omidpoyan/hardware/README.md

# Simple Oscilloscope Hardware

Top

- [Schematic.PDF](./Outputs/Schematic.PDF)
- [PCB 3D.PDF](./Outputs/PDF3D.PDF)
- [BOM.PDF](./Outputs/BOM.PDF)
