omidpoyan/hardware/Outputs/Schematic.PDF

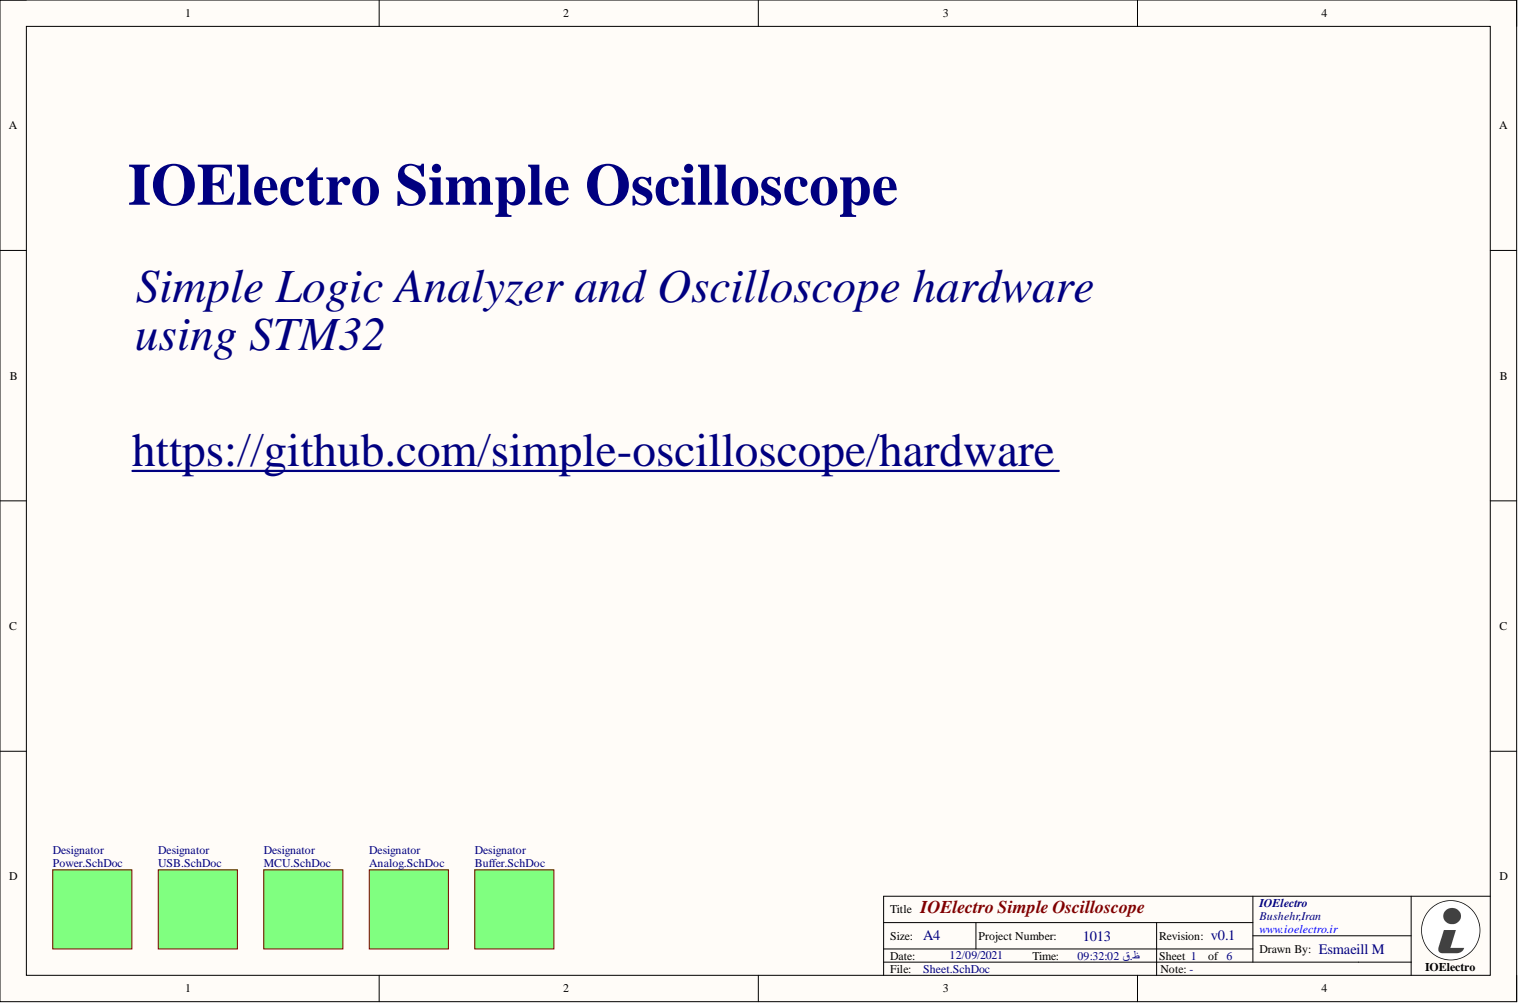
[picture p2: page 1]

Simple Logic Analyzer and Oscilloscope hardware
using STM32

https://github.com/simple-oscilloscope/hardware

Size: A4 | Project Number: 1013 | Revision: v0.1
Date: Time: ظ.ق 09:32:02 12/09/2021 | | Sheet of

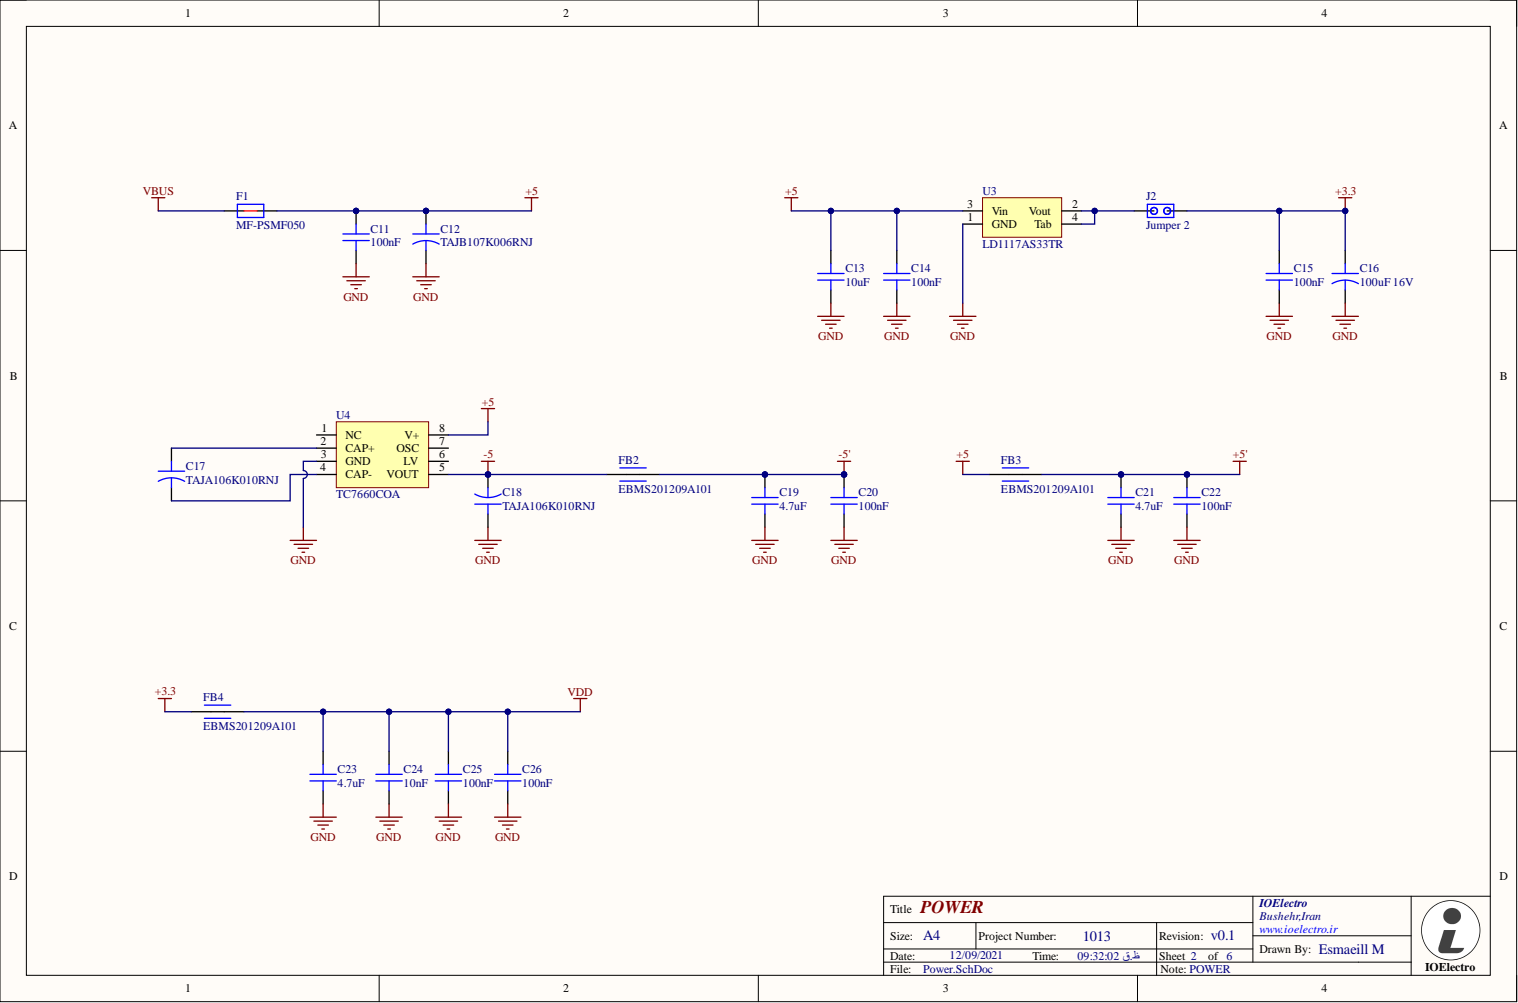
[picture p3: page 2]

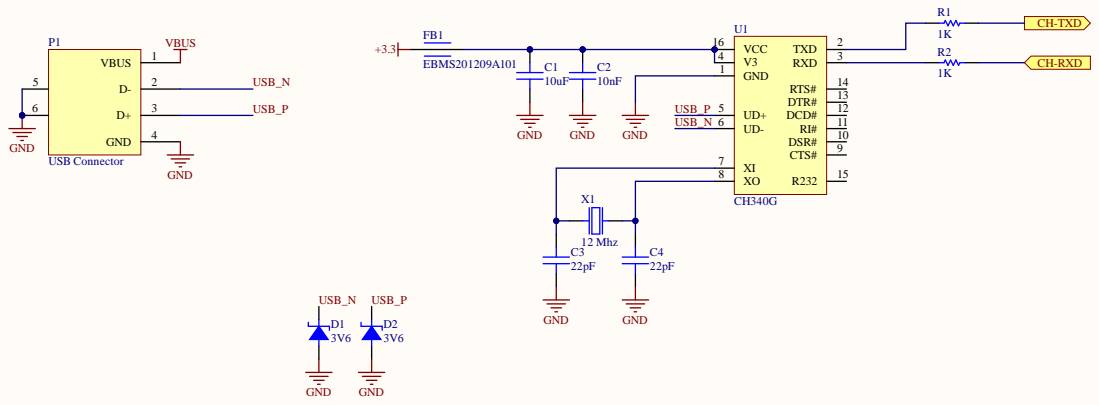
[picture p4: page 3]

Size: A | Project N u mber: | Rev i s n v .

/ Ti me: : ق ظ | | Shee t f

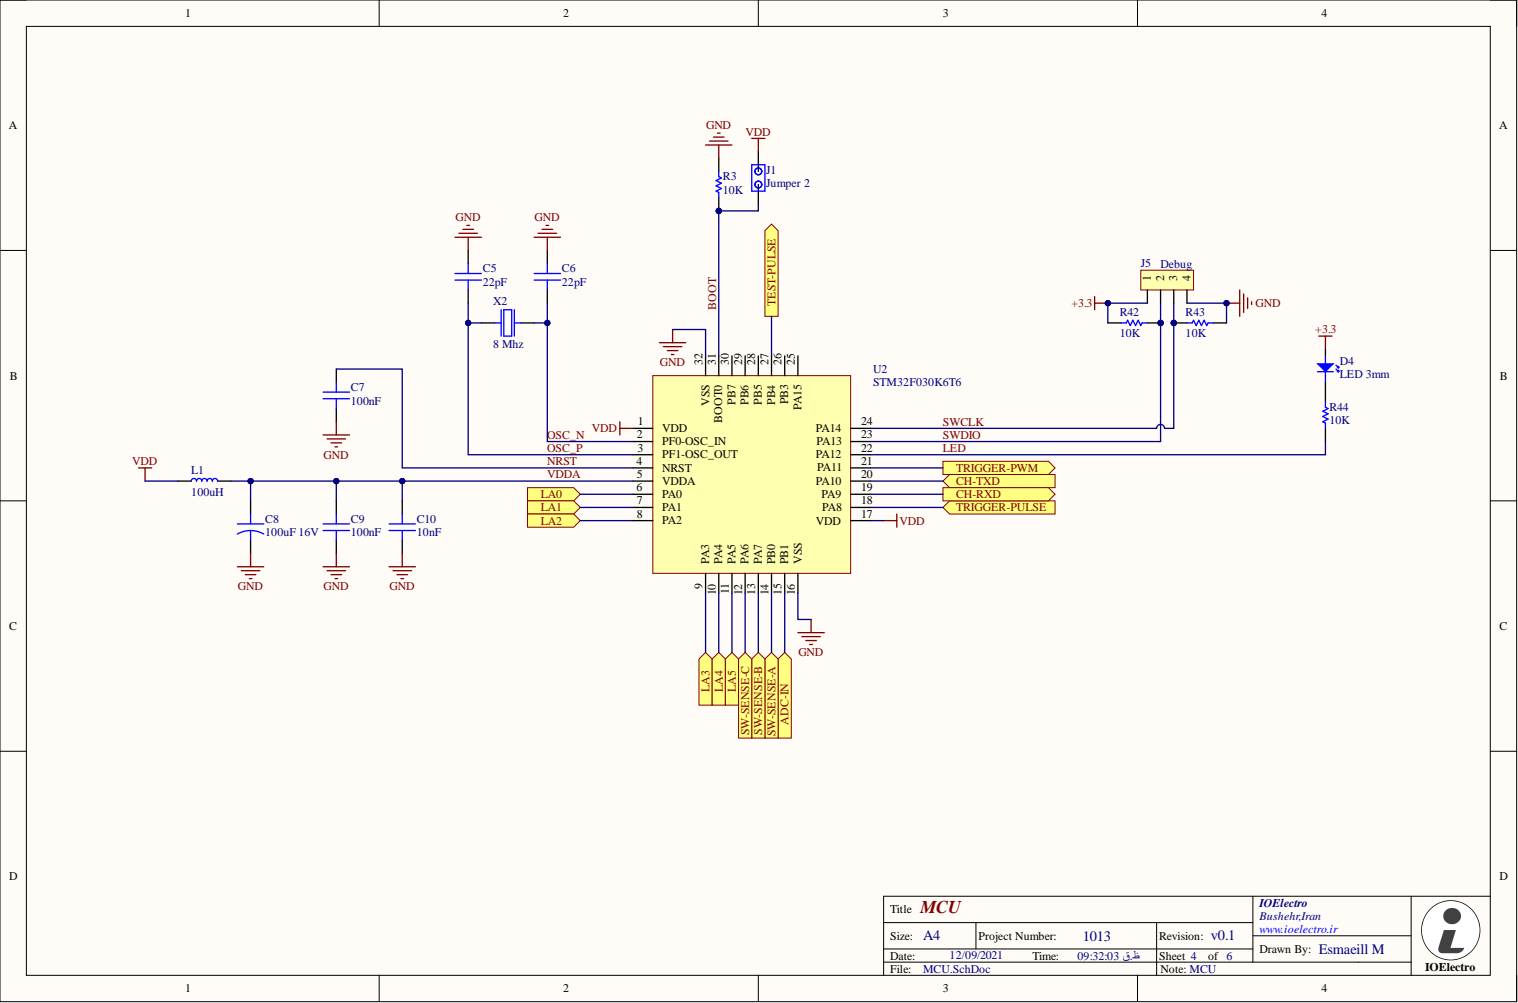
[picture p5: page 4]

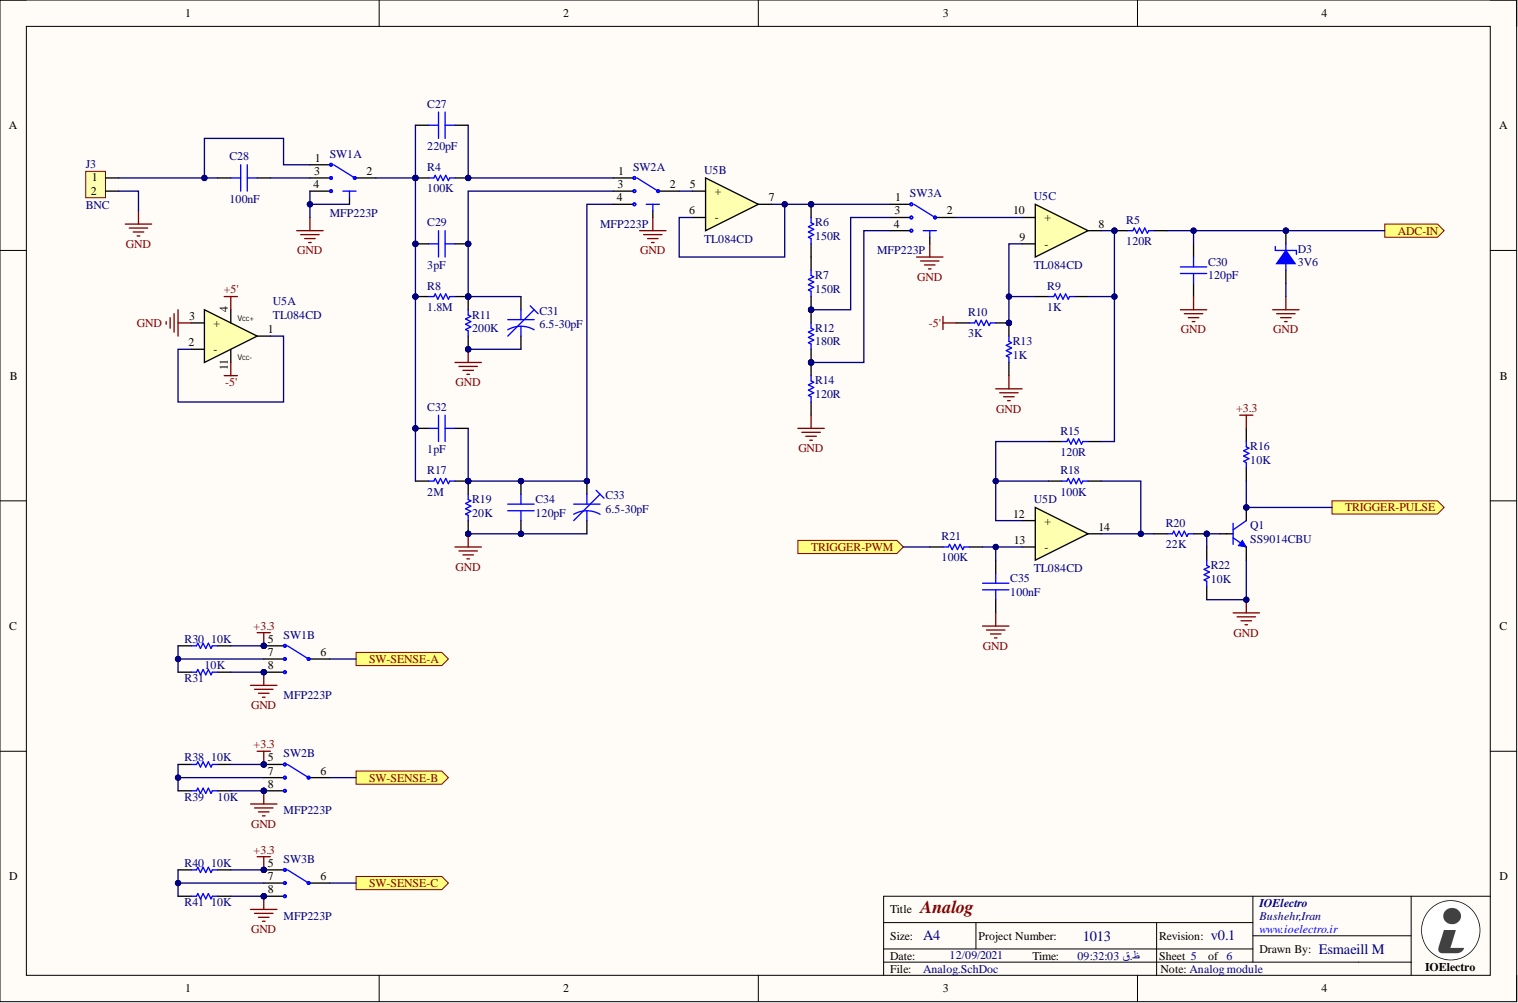
[picture p6: page 5]

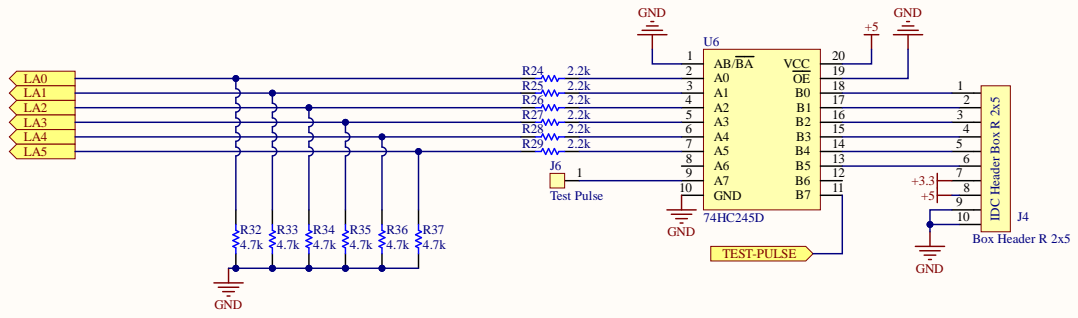
[picture p7: page 6]
