omidpoyan/hardware/(list of files, drawings)

Other design files:
Analog.SchDoc
Buffer.SchDoc
IOElectro_SimpleOscilloscope.PrjPcb
MCU.SchDoc
PCB.PcbDoc
Power.SchDoc
Sheet.SchDoc
USB.SchDoc
