omidpoyan/hardware/(commit log)

2021-08-26 first init
    [Analog-PCB_Project.PrjPcb, Main-PCB_Project.PrjPcb, PCB.PcbDoc, Sheet.SchDoc]
2021-08-26 assambly test
    [PCB.PcbDoc, Sheet.SchDoc]
2021-08-26 add trimmer cap
    [Sheet.SchDoc]
2021-08-27 add title and seperate main board pages
    [MCU.SchDoc, Main-PCB_Project.PrjPcb, POWER.SchDoc, Sheet.SchDoc, USB.SchDoc]
2021-08-28 one pcb
    [Analog-PCB_Project.PrjPcb, Analog.SchDoc, MCU.SchDoc, Main-PCB_Project.PrjPcb, PCB.PcbDoc, PCB_Project.PrjPcb, POWER.SchDoc, Power.SchDoc]
2021-08-29 fix power of mcu
    [Analog.SchDoc, MCU.SchDoc, PCB.PcbDoc, Power.SchDoc, USB.SchDoc]
2021-08-29 add buffer
    [Analog.SchDoc, Buffer.SchDoc, MCU.SchDoc, PCB_Project.PrjPcb, Power.SchDoc, Sheet.SchDoc, USB.SchDoc]
2021-09-03 first pcb placement
    [Analog.SchDoc, Buffer.SchDoc, MCU.SchDoc, PCB_Project.PrjPcb, Power.SchDoc, Sheet.SchDoc, USB.SchDoc]
2021-09-03 draw pcb tracks 00
    [USB.SchDoc]
2021-09-03 end of trace lines
2021-09-03 add poligon
    [PCB_Project.PrjPcb, USB.SchDoc]
2021-09-05 change clearance to 0.25mm
2021-09-06 Send for product
    [PCB_Project.PrjPcb, USB.SchDoc]
2021-09-12 rename files
    [Analog.SchDoc, Bill of Materials-IOElectro_SimpleOscilloscope.xlsx, Buffer.SchDoc, IOElectro_SimpleOscilloscope.PrjPcb, MCU.SchDoc, PCB_Project.PrjPcb, Power.SchDoc, Sheet.SchDoc]
2021-09-12 rename output folder
    [Bill of Materials-IOElectro_SimpleOscilloscope.xlsx, IOElectro_SimpleOscilloscope.PrjPcb]
2021-09-12 update bom
    [Bill of Materials-IOElectro_SimpleOscilloscope.xlsx, IOElectro_SimpleOscilloscope.PrjPcb]
